Matos-Ricardo/encosta-viva_Maker/hardware/fusion360/Robo_Modelo_02_original/DXF_nominal/H04_BASE.dxf

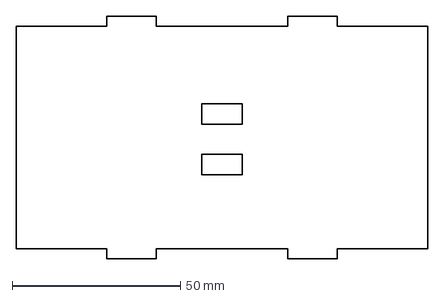
[picture p3: CAD file, 2026-11-12]
hardware/fusion360/Robo_Modelo_02_original/DXF_nominal/H04_BASE.dxf
122.0 x 72.0 mm
