Matos-Ricardo/encosta-viva_Maker/hardware/fusion360/T01_FRENTE_LED_3LEDS.dxf

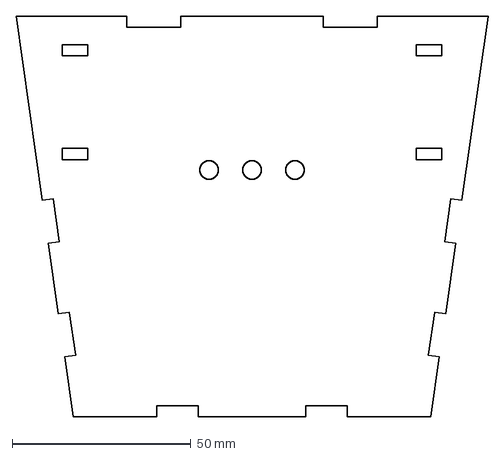
[picture p4: CAD file, 2026-11-12]
hardware/fusion360/T01_FRENTE_LED_3LEDS.dxf
132.0 x 112.0 mm
