Matos-Ricardo/encosta-viva_Maker/hardware/fusion360/Robo_Modelo_02_original/DXF_nominal/T05_PISO.dxf

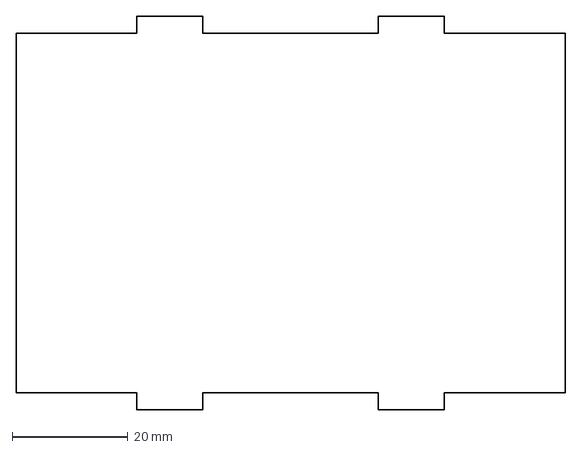
[picture p5: CAD file, 2026-11-12]
hardware/fusion360/Robo_Modelo_02_original/DXF_nominal/T05_PISO.dxf
94.8 x 68.0 mm
