Matos-Ricardo/encosta-viva_Maker/hardware/fusion360/Robo_Modelo_02_original/DXF_nominal/S_E_SUPORTE_SG90.dxf

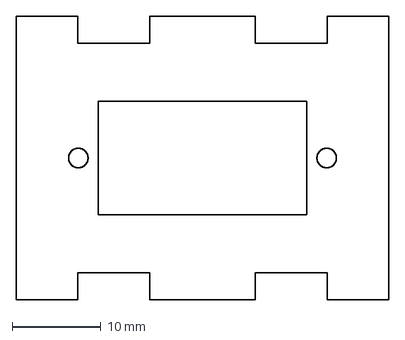
[picture p6: CAD file, 2026-11-12]
hardware/fusion360/Robo_Modelo_02_original/DXF_nominal/S_E_SUPORTE_SG90.dxf
42.0 x 32.0 mm
