Matos-Ricardo/encosta-viva_Maker/hardware/fusion360/Robo_Modelo_02_original/DXF_nominal/H01_FRENTE_LOSANGOS.dxf

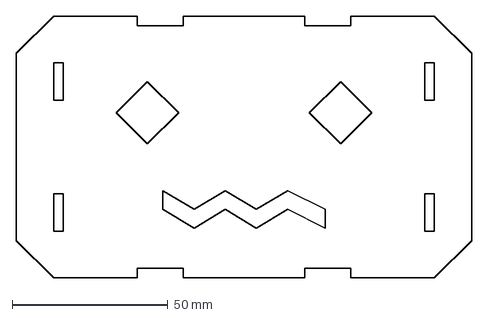
[picture p7: CAD file, 2026-11-12]
hardware/fusion360/Robo_Modelo_02_original/DXF_nominal/H01_FRENTE_LOSANGOS.dxf
146.0 x 84.0 mm
