Matos-Ricardo/encosta-viva_Maker/hardware/fusion360/Robo_Modelo_02_original/DXF_nominal/T03_LATERAL_D.dxf

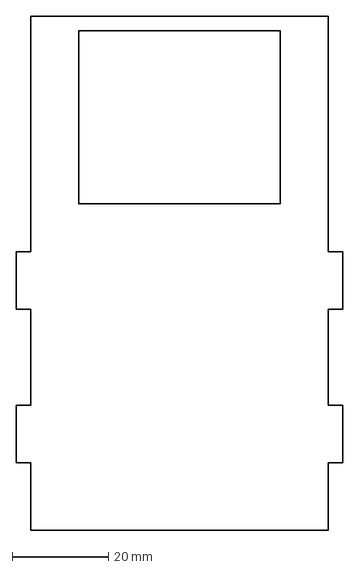
[picture p8: CAD file, 2026-11-12]
hardware/fusion360/Robo_Modelo_02_original/DXF_nominal/T03_LATERAL_D.dxf
68.0 x 107.1 mm
