Matos-Ricardo/encosta-viva_Maker/hardware/fusion360/Robo_Modelo_02_original/DXF_nominal/N01_PESCOCO.dxf

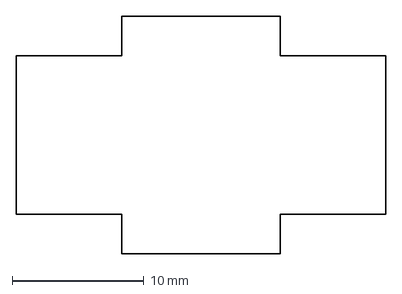
[picture p9: CAD file, 2026-11-12]
hardware/fusion360/Robo_Modelo_02_original/DXF_nominal/N01_PESCOCO.dxf
28.0 x 18.0 mm
