Matos-Ricardo/encosta-viva_Maker/hardware/fusion360/Robo_Modelo_02_original/DXF_nominal/T02_TAMPA_USB.dxf

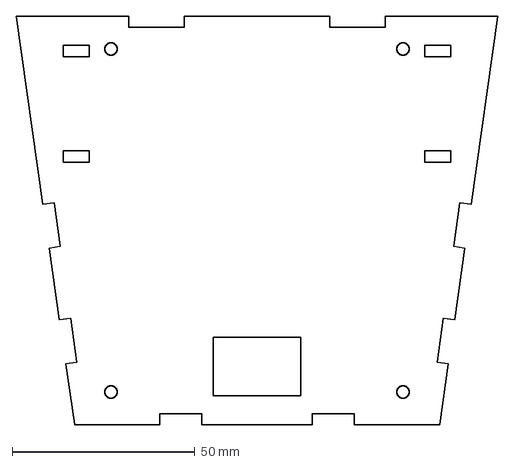
[picture p12: CAD file, 2026-11-12]
hardware/fusion360/Robo_Modelo_02_original/DXF_nominal/T02_TAMPA_USB.dxf
132.0 x 112.0 mm
