Matos-Ricardo/encosta-viva_Maker/hardware/fusion360/Robo_Modelo_02_original/DXF_nominal/H03_TOPO.dxf

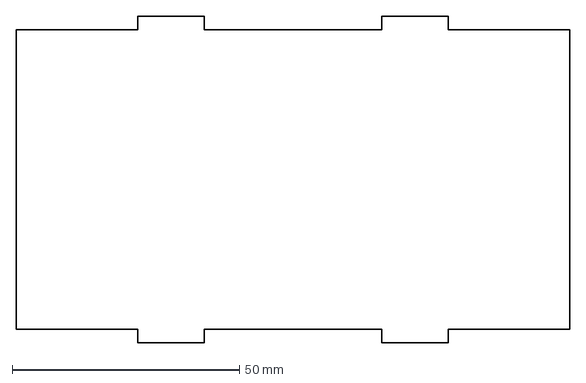
[picture p13: CAD file, 2026-11-12]
hardware/fusion360/Robo_Modelo_02_original/DXF_nominal/H03_TOPO.dxf
122.0 x 72.0 mm
