Matos-Ricardo/encosta-viva_Maker/hardware/fusion360/Robo_Modelo_02_original/DXF_nominal/T01_FRENTE_LED.dxf

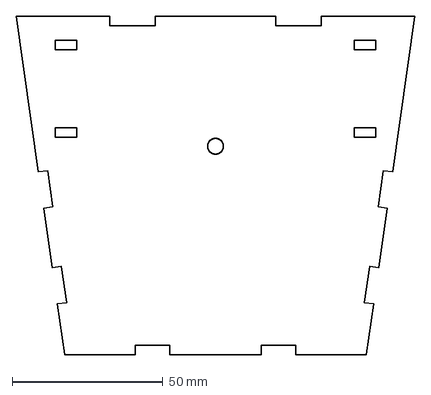
[picture p14: CAD file, 2026-11-12]
hardware/fusion360/Robo_Modelo_02_original/DXF_nominal/T01_FRENTE_LED.dxf
132.0 x 112.0 mm
